janelia-experimental-technology/mouse-joystick-pcb/docs/generated/mechanical/board-dimensions.md

# mouse-joystick-pcb Board Dimensions

Generated by `export_board_geometry.py`. Do not edit by hand.

All coordinates are millimetres in a right-handed frame whose **origin is the
centre of the board outline**, with **X to the right and Y up** when looking at
the top of the board. This is the frame mechanical CAD wants; it is not KiCad's.
The frame origin sits at KiCad coordinates (137.425, 95.0).

## Drawing

Outline and mounting holes, dimensioned

The outline and the mounting holes dimensioned, plotted by KiCad from a copy of the board with the dimensions on its `Dwgs.User` layer: [SVG](board-dimensions.svg) · [PDF](board-dimensions.pdf) (the PDF is the board's page, 1:1 when printed at 100 %). The cross is the centre of the outline, the origin of the tables below.

## Outline

| Property | Value |
| --- | --- |
| Shape | rounded rectangle |
| Width (X) | 100.0 mm |
| Height (Y) | 80.0 mm |
| Corner radius | 5.0 mm |
| X extent | -50.0 mm to 50.0 mm |
| Y extent | -40.0 mm to 40.0 mm |
| Board thickness | 1.6 mm |
| Copper layers | 4 |

## Stackup

| Layer | Type | Thickness (mm) | Material |
| --- | --- | --- | --- |
| F.SilkS | Top Silk Screen |  |  |
| F.Paste | Top Solder Paste |  |  |
| F.Mask | Top Solder Mask | 0.01 |  |
| F.Cu | copper | 0.035 |  |
| dielectric 1 | core | 0.48 | FR4 |
| In1.Cu | copper | 0.035 |  |
| dielectric 2 | prepreg | 0.48 | FR4 |
| In2.Cu | copper | 0.035 |  |
| dielectric 3 | core | 0.48 | FR4 |
| B.Cu | copper | 0.035 |  |
| B.Mask | Bottom Solder Mask | 0.01 |  |
| B.Paste | Bottom Solder Paste |  |  |
| B.SilkS | Bottom Silk Screen |  |  |

## Mounting Holes

| Ref | X (mm) | Y (mm) | Drill (mm) | Plated |
| --- | ---: | ---: | ---: | --- |
| H101 | -45.0 | 35.0 | 3.2 | no |
| H102 | 45.0 | 35.0 | 3.2 | no |
| H103 | 45.0 | -35.0 | 3.2 | no |
| H104 | -45.0 | -35.0 | 3.2 | no |

Unplated holes that belong to a connector or switch rather than to the
enclosure. They are drilled in the board but need no enclosure hardware.

| Ref | X (mm) | Y (mm) | Drill (mm) |
| --- | ---: | ---: | ---: |
| J201 | -45.0 | -15.0 | 0.71 |
| J201 | -45.0 | -7.0 | 0.71 |
| J301 | -42.9 | 13.715 | 3.25 |
| J301 | -42.9 | 2.285 | 3.25 |
| SW601 | -46.125 | -27.5 | 0.75 |
| SW601 | -48.875 | -27.5 | 0.75 |
| SW602 | -46.125 | -20.5 | 0.75 |
| SW602 | -48.875 | -20.5 | 0.75 |

## Connectors and Controls

`X` and `Y` are the footprint origin. The courtyard columns are the part's
keep-clear rectangle in the same frame, which is what a panel cutout needs.

| Ref | Value | Side | X (mm) | Y (mm) | Rot | Courtyard X | Courtyard Y |
| --- | --- | --- | ---: | ---: | ---: | --- | --- |
| J201 | USB-C | top | -45.0 | -11.0 | 90 | -47.31 to -42.69 | -16.05 to -5.95 |
| J301 | RJ45-8P8C | top | -41.0 | 8.0 | 270 | -50.0 to -32.0 | -0.5 to 16.5 |
| J501 | TBH-1x02-5.08mm | top | -44.0 | 24.0 | 270 | -48.3 to -38.7 | 17.41 to 30.58 |
| J901 | Conn_Coaxial_HL-BNC-KHDA | top | 16.0 | -15.0 | 0 | 9.5 to 22.5 | -21.5 to -8.5 |
| J1101 | Conn_Coaxial_HL-BNC-KHDA | top | -8.0 | -15.0 | 180 | -14.5 to -1.5 | -21.5 to -8.5 |
| J1102 | TBH-1x04-3.5mm | top | -21.0 | 36.0 | 180 | -29.2 to -12.8 | 31.25 to 39.5 |
| J1103 | TBH-1x05-3.5mm | top | 1.0 | 36.0 | 180 | -8.95 to 10.95 | 31.25 to 39.5 |
| J1301 | FH12-50S-0.5SVA(54) | top | 0.0 | -36.0 | 180 | -14.75 to 14.75 | -38.8 to -33.2 |
| J1601 | TBH-1x02-3.5mm | top | 18.0 | 36.0 | 180 | 13.3 to 22.7 | 31.25 to 39.5 |
| J1801 | TBH-1x02-3.5mm | top | 37.0 | -12.0 | 180 | 32.3 to 41.7 | -16.75 to -8.5 |
| J2001 | TBH-1x05-3.5mm | top | 37.0 | 18.0 | 180 | 27.05 to 46.95 | 13.25 to 21.5 |
| SW601 | 436333045822 | top | -47.5 | -27.5 | 270 | -49.5 to -45.5 | -31.0 to -24.0 |
| SW602 | 436333045822 | top | -47.5 | -20.5 | 270 | -49.5 to -45.5 | -24.0 to -17.0 |
