janelia-experimental-technology/mouse-joystick-pcb/docs/index.md

# mouse-joystick-pcb

<!-- Generated by orb-weaver-kicad-docs (scripts/board_view.py); do not edit. -->

Single-axis mouse joystick: RP2040 with GPIO isolation, one TMC5130A, torque bridge, brake current sink, analog angle output, InstrumentPort-Digital-50 taps, 36 V protected input with 12 V and 5 V regulators; v1.0 as built.

The assembled board with its design blocks numbered. On the site the picture is a model that turns, or the top
render where WebGL is absent, and each number is a link to the block's page: its schematic, parts, ports and
placement guidance. Read on the forge, the picture is the plain top render and the table below is the key.

<script type="module" src="https://ajax.googleapis.com/ajax/libs/model-viewer/4.0.0/model-viewer.min.js"></script>

<script>
(function(){try{var c=document.createElement('canvas');if('customElements' in window&&(c.getContext('webgl2')||c.getContext('webgl')))document.documentElement.classList.add('webgl');}catch(e){}})();
</script>

<style>
.board-3d{display:none}html.webgl .board-3d{display:block}html.webgl .board-2d{display:none}.board-plain{display:none}
@media print{.board-3d{display:none !important}.board-2d{display:block !important}}
.hotspot{display:block;width:22px;height:22px;border-radius:11px;border:2px solid #fff;background:#d9480f;color:#fff;font:bold 11px/18px sans-serif;text-align:center;text-decoration:none;box-shadow:0 1px 3px rgba(0,0,0,.4)}
.hotspot::before{content:attr(data-n)}.hotspot:hover{background:#a63a0b}
.board-hint{font-size:.8em;opacity:.75;margin:.4em 0 0}
</style>

<div class="board-3d">
<model-viewer id="board" src="generated/3d/mouse-joystick-pcb.glb?v=259a838d8eb5" alt="The assembled mouse-joystick-pcb" camera-controls touch-action="pan-y"
 camera-orbit="0deg 30deg auto" field-of-view="30deg" shadow-intensity="0.5" exposure="0.75" interaction-prompt="none"
 style="width:100%;height:560px;background:#fff;border-radius:8px">

</model-viewer>
<p class="board-hint">Drag to turn, scroll to zoom; the numbers are links.</p>
<script>
(function(){var mv=document.getElementById('board');if(!mv)return;
var fallback=function(){document.documentElement.classList.remove('webgl');};
mv.addEventListener('error',fallback);var t=setTimeout(fallback,20000);
if(window.customElements)customElements.whenDefined('model-viewer').then(function(){clearTimeout(t);});})();
</script>
</div>

<div class="board-2d">
<object data="generated/3d/top.svg?v=ad2ede290a01" type="image/svg+xml" style="width:100%" aria-label="The top of the board with the blocks numbered"></object>
<p class="board-hint">The numbers are links; in a browser with WebGL this picture is a model that turns.</p>
</div>

<div class="board-plain" markdown>

Top, straight down

</div>

| # | Block instance | Library block | On sheet | Side | Parts |
| ---: | --- | --- | --- | --- | ---: |
| 1 | [`hv_input_36V_terminal_2pos_5p08_protected_vertical`](generated/blocks/hv_input_36V_terminal_2pos_5p08_protected_vertical.md) | `orb_weaver_private:hv_input_36V_terminal_2pos_5p08_protected_vertical` | `/` | top | 18 |
| 2 | [`quadrature_encoder_input_5v_sn74lvc2g17`](generated/blocks/quadrature_encoder_input_5v_sn74lvc2g17.md) | `orb_weaver_private:quadrature_encoder_input_5v_sn74lvc2g17` | `/motor_encoder_switch` | top | 14 |
| 3 | [`limit_switch_debounced_input_vertical`](generated/blocks/limit_switch_debounced_input_vertical.md) | `orb_weaver_private:limit_switch_debounced_input_vertical` | `/motor_encoder_switch` | top | 5 |
| 4 | [`hv_to_12v_tpsm365r6`](generated/blocks/hv_to_12v_tpsm365r6.md) | `orb_weaver_tpsm365r6_adjustable:tpsm365r6_adjustable_12v` | `/brake_torque_sensor` | top | 13 |
| 5 | [`pycontrol_behavior_port_rj45_boundary_vertical`](generated/blocks/pycontrol_behavior_port_rj45_boundary_vertical.md) | `orb_weaver_private:pycontrol_behavior_port_rj45_boundary_vertical` | `/` | top | 9 |
| 6 | [`hv_to_5v_tpsm365r6`](generated/blocks/hv_to_5v_tpsm365r6.md) | `orb_weaver_tpsm365r6_fixed:tpsm365r6_fixed_5v` | `/` | top | 9 |
| 7 | [`tmc5130`](generated/blocks/tmc5130.md) | `orb_weaver_tmc5130:tmc5130_spi_r150` | `/motor_encoder_switch` | top | 27 |
| 8 | [`torque_bridge_0_3v3_ina821`](generated/blocks/torque_bridge_0_3v3_ina821.md) | `orb_weaver_private:torque_bridge_0_3v3_ina821` | `/brake_torque_sensor` | top | 63 |
| 9 | [`rp2040_with_gpio_isolation_sn74cb3q3245`](generated/blocks/rp2040_with_gpio_isolation_sn74cb3q3245.md) | `orb_weaver_private:rp2040_with_gpio_isolation_sn74cb3q3245` | `/mcu` | top | 35 |
| 10 | [`usb2_vertical`](generated/blocks/usb2_vertical.md) | `orb_weaver_private:usb2_vertical` | `/` | top | 6 |
| 11 | [`5v_to_3v3_tps73733_1`](generated/blocks/5v_to_3v3_tps73733_1.md) | `orb_weaver_private:5v_to_3v3_tps73733` | `/mcu` | top | 3 |
| 12 | [`5v_to_3v3_tps73733_2`](generated/blocks/5v_to_3v3_tps73733_2.md) | `orb_weaver_private:5v_to_3v3_tps73733` | `/` | top | 3 |
| 13 | [`analog_output_0_3v3_dac80501`](generated/blocks/analog_output_0_3v3_dac80501.md) | `orb_weaver_private:analog_output_0_3v3_dac80501` | `/motor_encoder_switch` | top | 28 |
| 14 | [`brake_current_sink_0_49ma_dac80501`](generated/blocks/brake_current_sink_0_49ma_dac80501.md) | `orb_weaver_private:brake_current_sink_0_49ma_dac80501` | `/brake_torque_sensor` | top | 54 |
| 15 | [`instrument_port_digital_50_dut_ffc_boundary_vertical`](generated/blocks/instrument_port_digital_50_dut_ffc_boundary_vertical.md) | `orb_weaver_private:instrument_port_digital_50_dut_ffc_boundary_vertical` | `/instrument_port` | top | 46 |

The numbers run left to right, top to bottom over the top view. The model is
[`3d/mouse-joystick-pcb.glb`](generated/3d/mouse-joystick-pcb.glb) (metres, Y up, the board's x and y along X and Z); the drawing
[`3d/top.svg`](generated/3d/top.svg) is [`3d/top.png`](generated/3d/top.png) at
12.38 px/mm with one rectangle per block, the union of its footprints' courtyards; both and the
footprints of each block are recorded in [`3d/hotspots.json`](generated/3d/hotspots.json).
Each block's page shows the render clipped around its rectangle.

## Where to go

- [Generated documentation](generated/README.md): the renders, every document, the bill of materials and the enclosure reference.
- [Design blocks](generated/blocks/README.md): one page per placed block, with its schematic, parts, ports and place on the board.
- [Subsystems](generated/subsystems/README.md) from their recipes, and the [MCU pin allocation](generated/gpio-allocation.md).
- The navigation lists the board's own pages.
