janelia-experimental-technology/mouse-joystick-pcb/docs/instrument-port-tap-resistors.md

# InstrumentPort Tap Resistors

**Status: implemented 2026-09-20 and verified against the exported netlist.**
This document is the build order for splitting every InstrumentPort observation
branch off its functional net with a series resistor. It is written to be
executed in a fresh session: everything needed — values, nets, owning blocks, pin
names, part numbers and the traps — is here. See
[As Built](#as-built-2026-09-20) for what actually landed and the two places the
build deviated from this specification.

**Read first:** [`docs/interface-map.md`](interface-map.md) →
[InstrumentPort-Digital-50 Pinout](interface-map.md#instrumentport-digital-50-pinout),
[Where Each Signal Is Tapped](interface-map.md#where-each-signal-is-tapped) and
[Board-Level Input Biases](interface-map.md#board-level-input-biases); then
[`docs/design-block-map.md`](design-block-map.md) for the re-place rules.

## What This Changes

Today a monitored signal is one net with three or more terminals: the driver,
the peripheral, and a long run to an `SN74LV541A` input in the port block. After
this change it is two nets joined by a series resistor — a T-tap, with the
resistor in the **branch**, never in the functional path:

```
  driver ───┬──────────────── peripheral        net: TMC_SPI_SCK      (short, direct)
            │
            └──[ R ]───────── SN74LV541A input  net: TMC_SPI_SCK_INST (long, deferrable)
```

Three things this buys, in order of how much they matter here:
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
