janelia-experimental-technology/mouse-joystick-pcb/docs/datasheets/torque-sensor-specs.png

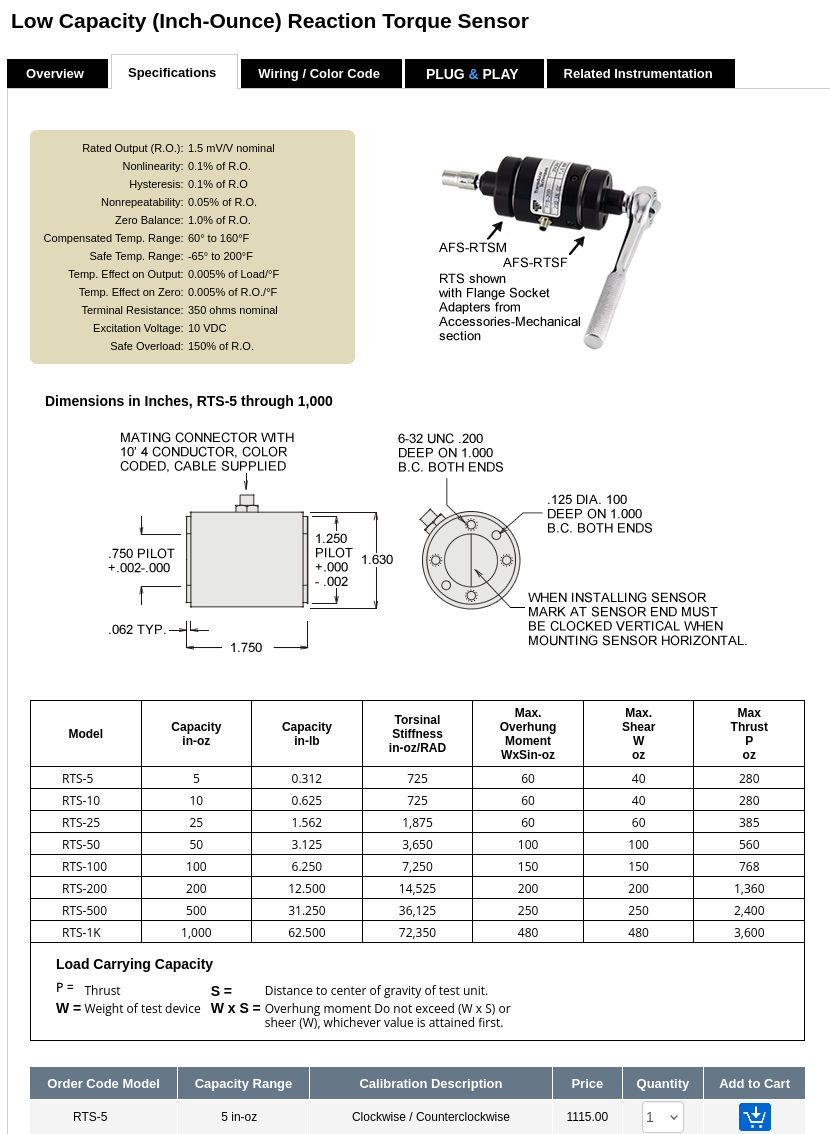
docs/datasheets/torque-sensor-specs.png
