janelia-experimental-technology/mouse-joystick-pcb/docs/diagrams/protocol-states.png

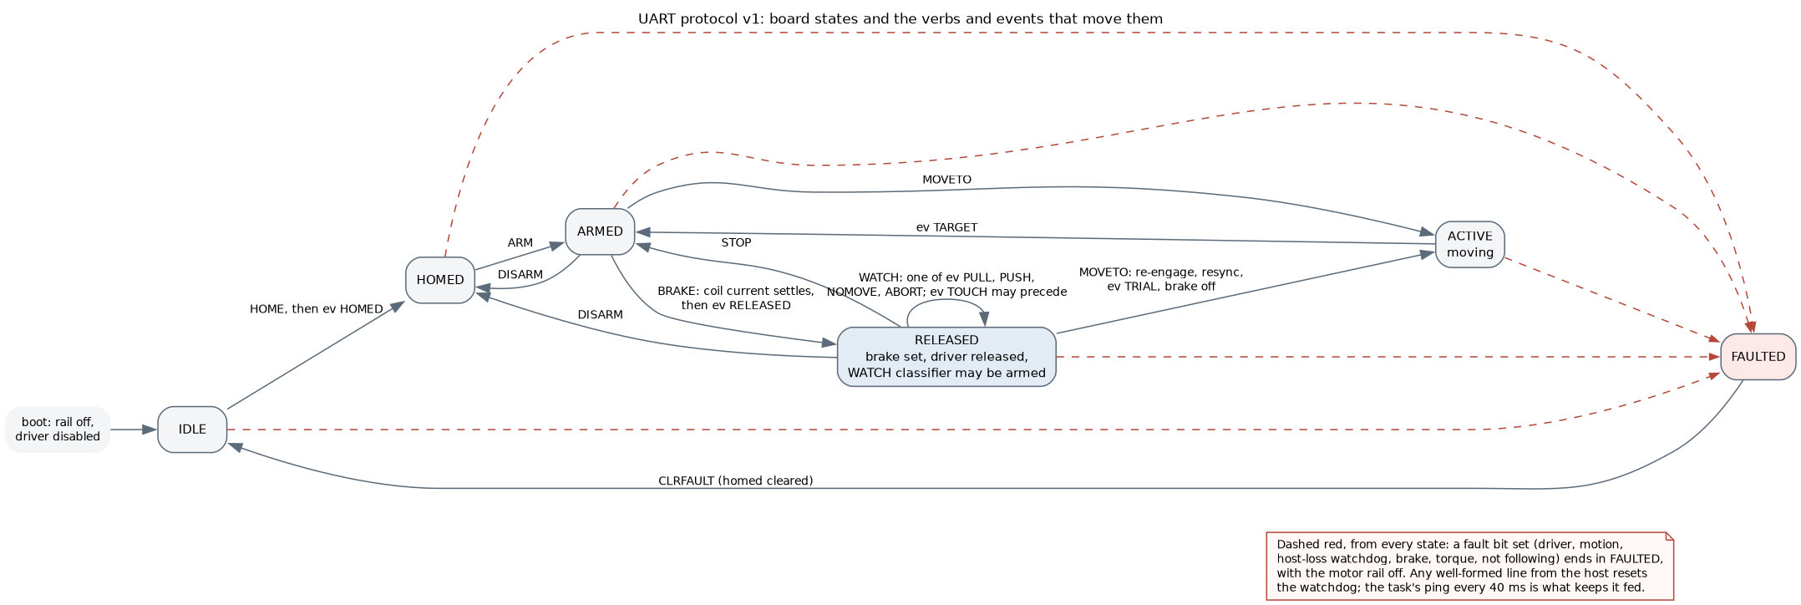
docs/diagrams/protocol-states.png
