janelia-experimental-technology/mouse-joystick-pcb/docs/generated/blocks/layout/5v_to_3v3_tps73733_1.png

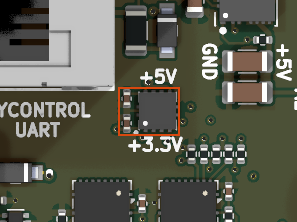
docs/generated/blocks/layout/5v_to_3v3_tps73733_1.png
