janelia-experimental-technology/mouse-joystick-pcb/docs/generated/blocks/layout/analog_output_0_3v3_dac80501.png

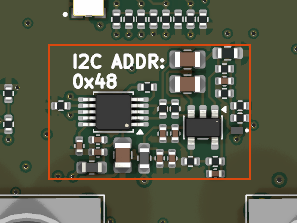
docs/generated/blocks/layout/analog_output_0_3v3_dac80501.png
