janelia-experimental-technology/mouse-joystick-pcb/docs/generated/blocks/layout/brake_current_sink_0_49ma_dac80501.png

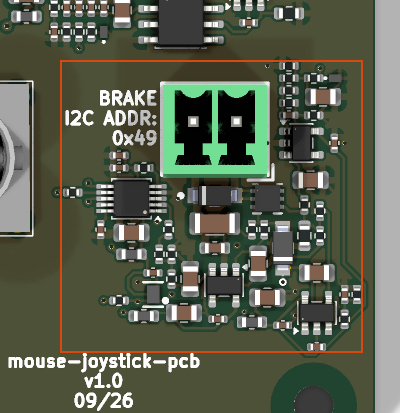
docs/generated/blocks/layout/brake_current_sink_0_49ma_dac80501.png
