janelia-experimental-technology/mouse-joystick-pcb/docs/generated/blocks/layout/hv_input_36V_terminal_2pos_5p08_protected_vertical.png

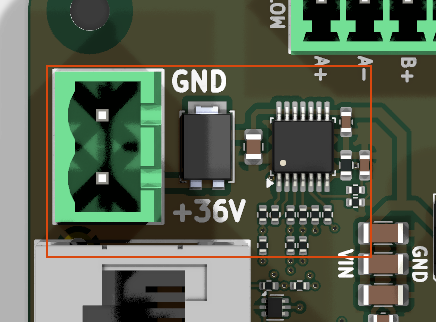
docs/generated/blocks/layout/hv_input_36V_terminal_2pos_5p08_protected_vertical.png
