janelia-experimental-technology/mouse-joystick-pcb/docs/generated/blocks/layout/hv_to_5v_tpsm365r6.png

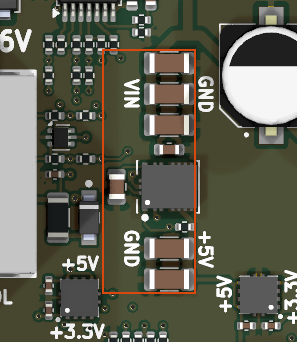
docs/generated/blocks/layout/hv_to_5v_tpsm365r6.png
