janelia-experimental-technology/mouse-joystick-pcb/docs/generated/blocks/layout/instrument_port_digital_50_dut_ffc_boundary_vertical.png

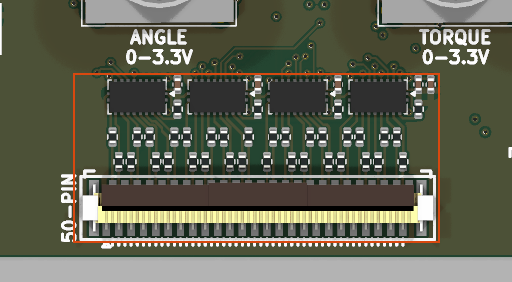
docs/generated/blocks/layout/instrument_port_digital_50_dut_ffc_boundary_vertical.png
