janelia-experimental-technology/mouse-joystick-pcb/docs/generated/blocks/layout/limit_switch_debounced_input_vertical.png

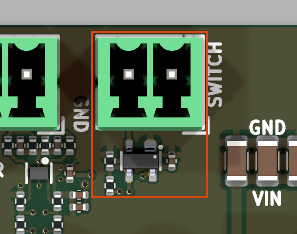
docs/generated/blocks/layout/limit_switch_debounced_input_vertical.png
