janelia-experimental-technology/mouse-joystick-pcb/docs/generated/blocks/layout/pycontrol_behavior_port_rj45_boundary_vertical.png

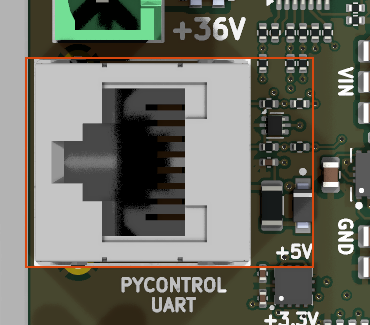
docs/generated/blocks/layout/pycontrol_behavior_port_rj45_boundary_vertical.png
