janelia-experimental-technology/mouse-joystick-pcb/docs/generated/blocks/layout/quadrature_encoder_input_5v_sn74lvc2g17.png

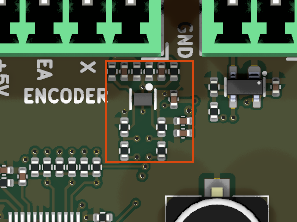
docs/generated/blocks/layout/quadrature_encoder_input_5v_sn74lvc2g17.png
