janelia-experimental-technology/mouse-joystick-pcb/docs/generated/blocks/layout/rp2040_with_gpio_isolation_sn74cb3q3245.png

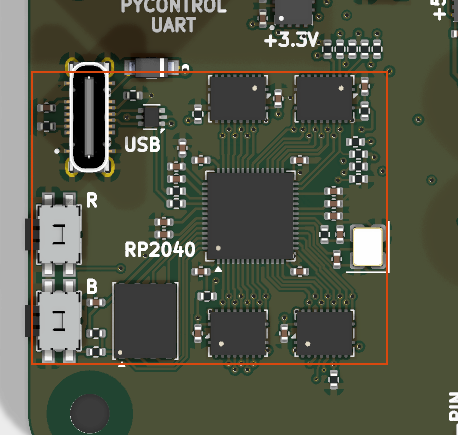
docs/generated/blocks/layout/rp2040_with_gpio_isolation_sn74cb3q3245.png
