janelia-experimental-technology/mouse-joystick-pcb/docs/generated/blocks/layout/tmc5130.png

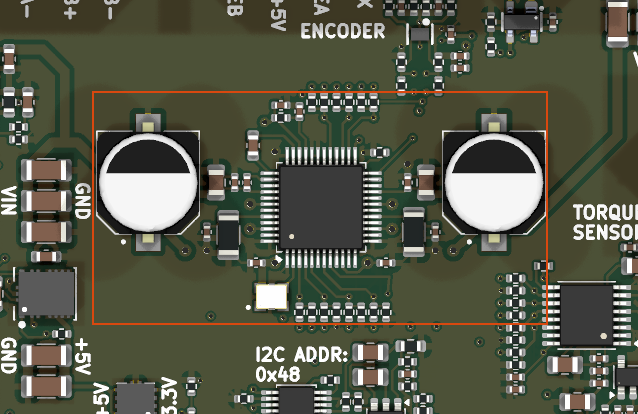
docs/generated/blocks/layout/tmc5130.png
