janelia-experimental-technology/mouse-joystick-pcb/docs/generated/blocks/layout/torque_bridge_0_3v3_ina821.png

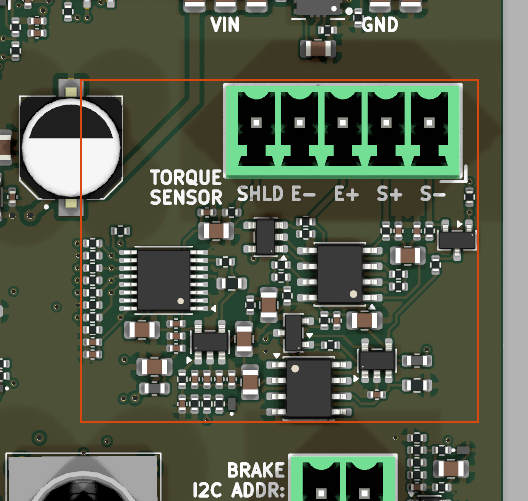
docs/generated/blocks/layout/torque_bridge_0_3v3_ina821.png
