janelia-experimental-technology/mouse-joystick-pcb/docs/generated/blocks/layout/usb2_vertical.png

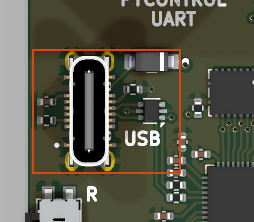
docs/generated/blocks/layout/usb2_vertical.png
