janelia-experimental-technology/mouse-joystick-pcb/docs/generated/mechanical/connectors.csv

reference | value | footprint | side | x_mm | y_mm | rotation_deg | courtyard_min_x_mm | courtyard_min_y_mm | courtyard_max_x_mm | courtyard_max_y_mm
J201 | USB-C | orb_weaver_connectors:USB_C_Receptacle_GCT_USB4145-03-0070-C_16P_Vertical | top | -45.0 | -11.0 | 90.0 | -47.31 | -16.05 | -42.69 | -5.95
J301 | RJ45-8P8C | orb_weaver_connectors:RJ45_Molex_855085001_Vertical_THT | top | -41.0 | 8.0 | 270.0 | -50.0 | -0.5 | -32.0 | 16.5
J501 | TBH-1x02-5.08mm | orb_weaver_tht:PhoenixContact_MSTBVA_2,5_2-G-5,08_1x02_P5.08mm_Vertical | top | -44.0 | 24.0 | 270.0 | -48.3 | 17.41 | -38.7 | 30.58
J901 | Conn_Coaxial_HL-BNC-KHDA | orb_weaver_connectors:CONN_BNC_HL-BNC-KHDA | top | 16.0 | -15.0 | 0.0 | 9.5 | -21.5 | 22.5 | -8.5
J1101 | Conn_Coaxial_HL-BNC-KHDA | orb_weaver_connectors:CONN_BNC_HL-BNC-KHDA | top | -8.0 | -15.0 | 180.0 | -14.5 | -21.5 | -1.5 | -8.5
J1102 | TBH-1x04-3.5mm | orb_weaver_tht:PhoenixContact_MCV_1,5_4-G-3.5_1x04_P3.50mm_Vertical | top | -21.0 | 36.0 | 180.0 | -29.2 | 31.25 | -12.8 | 39.5
J1103 | TBH-1x05-3.5mm | orb_weaver_tht:PhoenixContact_MCV_1,5_5-G-3.5_1x05_P3.50mm_Vertical | top | 1.0 | 36.0 | 180.0 | -8.95 | 31.25 | 10.95 | 39.5
J1301 | FH12-50S-0.5SVA(54) | orb_weaver_connectors:Hirose_FH12-50S-0.5SVA_1x50-4MP_P0.5mm_Vertical | top | 0.0 | -36.0 | 180.0 | -14.75 | -38.8 | 14.75 | -33.2
J1601 | TBH-1x02-3.5mm | orb_weaver_tht:PhoenixContact_MCV_1,5_2-G-3.5_1x02_P3.50mm_Vertical | top | 18.0 | 36.0 | 180.0 | 13.3 | 31.25 | 22.7 | 39.5
J1801 | TBH-1x02-3.5mm | orb_weaver_tht:PhoenixContact_MCV_1,5_2-G-3.5_1x02_P3.50mm_Vertical | top | 37.0 | -12.0 | 180.0 | 32.3 | -16.75 | 41.7 | -8.5
J2001 | TBH-1x05-3.5mm | orb_weaver_tht:PhoenixContact_MCV_1,5_5-G-3.5_1x05_P3.50mm_Vertical | top | 37.0 | 18.0 | 180.0 | 27.05 | 13.25 | 46.95 | 21.5
SW601 | 436333045822 | orb_weaver_smd:SMT_1045822_WRE | top | -47.5 | -27.5 | 270.0 | -49.5 | -31.0 | -45.5 | -24.0
SW602 | 436333045822 | orb_weaver_smd:SMT_1045822_WRE | top | -47.5 | -20.5 | 270.0 | -49.5 | -24.0 | -45.5 | -17.0
