janelia-experimental-technology/mouse-joystick-pcb/docs/generated/bom/mouse-joystick-pcb-bom.md

# mouse-joystick-pcb Bill of Materials

Generated by `orb-weaver-kicad-docs`. Do not edit by hand.

81 distinct parts, 360 placements. `LCSC` is the JLCPCB
catalog number the assembly BOM resolves to, linked to its LCSC page; the
datasheet is the catalog's where it records one (33 of 81 parts).

| Qty | References | Value | Package | Manufacturer | MPN | LCSC | Datasheet |
| --- | --- | --- | --- | --- | --- | --- | --- |
| 12 | C1001, C1002, C2017, C2019, C2021, C603, C604, C701, C702, C801, C804, C806 | 1uF | 0402 | Samsung Electro-Mechanics | CL05A105KL5NRNC | [C307413](https://www.lcsc.com/product-detail/C307413.html) |  |
| 51 | C1201, C1203, C1204, C1206, C1207, C1209, C1210, C1302, C1303, C1304, C1305, C1504, C1505, C1601, C1805, C1806, C1807, C1809, C1810, C1813, C1814, C1816, C2001, C2007, C2009, C201, C2010, C2015, C2016, C2018, C2020, C2023, C301, C605, C606, C607, C608, C609, C610, C611, C612, C613, C614, C615, C616, C617, C618, C619, C803, C805, C808 | 100nF | 0402 | Murata Electronics | GRM155R62A104KE14D | [C162178](https://www.lcsc.com/product-detail/C162178.html) |  |
| 2 | C1202, C503 | 22nF | 0603 | Murata Electronics | GCM188R72A223KA37D | [C161234](https://www.lcsc.com/product-detail/C161234.html) |  |
| 3 | C1205, C1811, C811 | 0.47uF | 0402 | Murata Electronics | GRT155R6YA474KE01D | [C711580](https://www.lcsc.com/product-detail/C711580.html) |  |
| 3 | C1208, C1301, C1501 | 4.7uF | 0402 | Murata Electronics | GRM155R61E475ME15D | [C2858031](https://www.lcsc.com/product-detail/C2858031.html) |  |
| 2 | C1211, C1212 | 2.2uF | 0805 | Murata Electronics | GRM21BD72A225KE01L | [C2981733](https://www.lcsc.com/product-detail/C2981733.html) |  |
| 2 | C1213, C1214 | 100uF | SMD,D8xL10.2mm | Panasonic Electronic Components | EEEHAH101UAP | [C336425](https://www.lcsc.com/product-detail/C336425.html) |  |
| 6 | C1502, C1503, C2003, C2005, C2022, C812 | 470pF | 0402 | Murata Electronics | GRM1555C2A471JE01D | [C1518202](https://www.lcsc.com/product-detail/C1518202.html) |  |
| 6 | C1701, C1702, C1703, C1901, C1902, C1903 | 1uF | 1206 | FH (Guangdong Fenghua Advanced Tech) | 1206B105K101NT | [C91151](https://www.lcsc.com/product-detail/C91151.html) |  |
| 3 | C1704, C1818, C1904 | 100nF | 0603 | Murata Electronics | GRM188R72A104KA35D | [C77058](https://www.lcsc.com/product-detail/C77058.html) |  |
| 2 | C1705, C1905 | 1uF | 0805 | FH (Guangdong Fenghua Advanced Tech) | 0805B105K250NT | [C89190](https://www.lcsc.com/product-detail/C89190.html) |  |
| 2 | C1706, C1707 | 22uF | 1206 | FH (Guangdong Fenghua Advanced Tech) | 1206X226M100NT | [C108717](https://www.lcsc.com/product-detail/C108717.html) |  |
| 11 | C1801, C1808, C1812, C1815, C1820, C2002, C2004, C2006, C2008, C807, C809 | 10nF | 0805 | Murata Electronics | GRM2195C1H103JA01D | [C97905](https://www.lcsc.com/product-detail/C97905.html) |  |
| 8 | C1802, C1803, C1804, C2011, C2012, C2013, C2014, C802 | 10uF | 0805 | Samsung Electro-Mechanics | CL21A106KOQNNNE | [C1713](https://www.lcsc.com/product-detail/C1713.html) |  |
| 1 | C1817 | 470nF | 1206 |  | CGA1206X7R474K101NT | [C6119998](https://www.lcsc.com/product-detail/C6119998.html) |  |
| 2 | C1819, C810 | 10pF | 0402 | Murata Electronics | GRM1555C1E100JA01D | [C161512](https://www.lcsc.com/product-detail/C161512.html) |  |
| 2 | C1906, C1907 | 10uF | 1206 | Samsung Electro-Mechanics | CL31A106KAHNNNE | [C9807](https://www.lcsc.com/product-detail/C9807.html) |  |
| 1 | C501 | 10nF | 0603 | YAGEO | CC0603JRX7R9BB103 | [C115056](https://www.lcsc.com/product-detail/C115056.html) |  |
| 1 | C502 | 220nF | 0805 | YAGEO | CC0805KKX7R0BB224 | [C513710](https://www.lcsc.com/product-detail/C513710.html) |  |
| 2 | C601, C602 | 15pF | 0402 | KEMET | C0402C150J3GACAUTO | [C3888936](https://www.lcsc.com/product-detail/C3888936.html) |  |
| 3 | D1801, D201, D301 | MBR120VLSFT1G | SOD-123FL | onsemi | MBR120VLSFT1G | [C223608](https://www.lcsc.com/product-detail/C223608.html) | [datasheet](https://www.onsemi.com/pdf/datasheet/mbr120vlsft1-d.pdf) |
| 1 | D1802 | S115Q | SOD-123FL | Yangzhou Yangjie Electronic Technology | S115Q | [C5362393](https://www.lcsc.com/product-detail/C5362393.html) | [datasheet](https://www.lcsc.com/product-detail/C5362393.html) |
| 3 | D1803, D2001, D801 | TPD1E05U06DPYR | X1SON-2(0.6x1) | Texas Instruments | TPD1E05U06DPYR | [C436349](https://www.lcsc.com/product-detail/C436349.html) | [datasheet](https://www.ti.com/lit/ds/symlink/tpd1e05u06.pdf) |
| 1 | D501 | SBRT15U50SP5-13 | PowerDI-5 | Diodes Incorporated | SBRT15U50SP5-13 | [C211388](https://www.lcsc.com/product-detail/C211388.html) | [datasheet](https://www.diodes.com/assets/Datasheets/SBRT15U50SP5.pdf) |
| 7 | FB1801, FB1802, FB1803, FB2001, FB2002, FB801, FB802 | 600R@100MHz | 0603 | Taiyo Yuden | FCM1608KF-601T03 | [C141723](https://www.lcsc.com/product-detail/C141723.html) |  |
| 2 | J1101, J901 | Conn_Coaxial_HL-BNC-KHDA | Plugin | Shenzhen HenryTech | HL-BNC-KHDA | [C19712152](https://www.lcsc.com/product-detail/C19712152.html) | [datasheet](https://jlcpcb.com/partdetail/C19712152) |
| 1 | J1102 | TBH-1x04-3.5mm | Plugin,P=3.5mm | Phoenix Contact | 1843622 | [C480549](https://www.lcsc.com/product-detail/C480549.html) | [datasheet](https://www.phoenixcontact.com/en-pc/products/1843622) |
| 2 | J1103, J2001 | TBH-1x05-3.5mm | Plugin,P=3.5mm | Phoenix Contact | 1843635 | [C5451793](https://www.lcsc.com/product-detail/C5451793.html) | [datasheet](https://www.phoenixcontact.com/en-pc/products/1843635) |
| 1 | J1301 | FH12-50S-0.5SVA(54) | SMD,P=0.5mm | Hirose Electric | FH12-50S-0.5SVA(54) | [C597991](https://www.lcsc.com/product-detail/C597991.html) | [datasheet](https://www.hirose.com/product/en/products/FH12/FH12-50S-0.5SVA%2854%29/) |
| 2 | J1601, J1801 | TBH-1x02-3.5mm | Plugin,P=3.5mm | Phoenix Contact | 1843606 | [C3019639](https://www.lcsc.com/product-detail/C3019639.html) | [datasheet](https://www.phoenixcontact.com/en-pc/products/1843606) |
| 1 | J201 | USB-C | SMD | Global Connector Technology | USB4145-03-0070-C | [C5815189](https://www.lcsc.com/product-detail/C5815189.html) | [datasheet](https://gct.co/files/drawings/usb4145.pdf) |
| 1 | J301 | RJ45-8P8C | Plugin | Molex | 855085001 | [C588558](https://www.lcsc.com/product-detail/C588558.html) | [datasheet](https://www.molex.com/en-us/products/part-detail-pdf/855085001?display=pdf) |
| 1 | J501 | TBH-1x02-5.08mm | Plugin,P=5.08mm | Phoenix Contact | 1755736 | [C480503](https://www.lcsc.com/product-detail/C480503.html) | [datasheet](https://www.phoenixcontact.com/en-pc/products/1755736) |
| 1 | Q2001 | 2SK1589-T1B-VB | SOT-23 | VBsemi Elec | 2SK1589-T1B-VB | [C724949](https://www.lcsc.com/product-detail/C724949.html) | [datasheet](https://www.lcsc.com/product-detail/C724949.html) |
| 1 | Q2002 | MMBT5550LT1G | SOT-23 | onsemi | MMBT5550LT1G | [C150072](https://www.lcsc.com/product-detail/C150072.html) | [datasheet](https://www.onsemi.com/pdf/datasheet/mmbt5550lt1-d.pdf) |
| 29 | R1101, R1102, R1103, R1104, R1105, R1106, R1107, R1201, R1301, R1302, R1303, R1304, R1701, R2011, R2012, R401, R404, R405, R502, R503, R504, R506, R507, R605, R901, R902, R903, R904, R905 | 10k | 0402 | PANASONIC | ERJ2GEJ103X | [C278577](https://www.lcsc.com/product-detail/C278577.html) |  |
| 3 | R1202, R2002, R2014 | 10 | 0402 | YAGEO | RC0402FR-0710RL | [C138066](https://www.lcsc.com/product-detail/C138066.html) |  |
| 2 | R1203, R1204 | 0.15 | 1206 | TA-I Tech | RLH12FTCR150 | [C2683383](https://www.lcsc.com/product-detail/C2683383.html) |  |
| 48 | R1205, R1206, R1207, R1208, R1305, R1306, R1307, R1308, R1309, R1310, R1311, R1312, R1313, R1314, R1315, R1316, R1317, R1318, R1319, R1320, R1321, R1322, R1323, R1324, R1325, R1326, R1327, R1328, R1329, R1330, R1331, R1332, R1333, R1334, R1335, R1336, R1507, R1508, R2024, R2025, R2026, R2027, R301, R302, R304, R305, R410, R411 | 100 | 0402 | UNI-ROYAL(Uniroyal Elec) | 0402WGF1000TCE | [C25076](https://www.lcsc.com/product-detail/C25076.html) |  |
| 26 | R1209, R1210, R1211, R1602, R1807, R1809, R1813, R1820, R2004, R2005, R2013, R2022, R2028, R408, R409, R501, R505, R510, R511, R512, R603, R604, R606, R806, R808, R810 | 1k | 0402 | YAGEO | RC0402FR-071KL | [C106235](https://www.lcsc.com/product-detail/C106235.html) |  |
| 5 | R1501, R1502, R1505, R1506, R1601 | 100k | 0402 | YAGEO | RC0402JR-07100KL | [C106234](https://www.lcsc.com/product-detail/C106234.html) |  |
| 7 | R1503, R1504, R1903, R402, R403, R406, R407 | 4.7k | 0402 | UNI-ROYAL(Uniroyal Elec) | 0402WGF4701TCE | [C25900](https://www.lcsc.com/product-detail/C25900.html) |  |
| 10 | R1801, R1817, R1902, R1905, R2006, R2007, R2008, R2017, R2018, R803 | 10k | 0402 | Panasonic Electronic Components | ERA2AEB103X | [C191915](https://www.lcsc.com/product-detail/C191915.html) |  |
| 6 | R1802, R1805, R1806, R1811, R1814, R1815 | 49.9k | 0402 | YAGEO | RC0402FR-0749K9L | [C137969](https://www.lcsc.com/product-detail/C137969.html) |  |
| 10 | R1803, R1804, R1808, R1810, R1821, R2016, R2020, R804, R807, R811 | 3.2k | 0402 | Yageo | RT0402BRD073K2L | [C705066](https://www.lcsc.com/product-detail/C705066.html) |  |
| 1 | R1812 | 6.34k | 0402 | LIZ Elec | CR0402FF6341G | [C100502](https://www.lcsc.com/product-detail/C100502.html) |  |
| 1 | R1816 | 10 | 0603 | ROHM Semicon | KTR03EZPF10R0 | [C2090788](https://www.lcsc.com/product-detail/C2090788.html) |  |
| 2 | R1818, R1904 | 110k | 0402 | FOJAN | FRC0402F1103TS | [C2909311](https://www.lcsc.com/product-detail/C2909311.html) |  |
| 5 | R1819, R2021, R2023, R509, R809 | 249 | 0402 | Vishay Intertech | CRCW0402249RFKED | [C482112](https://www.lcsc.com/product-detail/C482112.html) |  |
| 2 | R1901, R607 | 7.87k | 0402 | FOJAN | FRC0402F7871TS | [C2998145](https://www.lcsc.com/product-detail/C2998145.html) |  |
| 1 | R2001 | 249 | 0402 | Yageo | RT0402BRD07249RL | [C852662](https://www.lcsc.com/product-detail/C852662.html) |  |
| 1 | R2003 | 75k | 0402 | Yageo | RT0402BRD0775KL | [C728563](https://www.lcsc.com/product-detail/C728563.html) |  |
| 1 | R2009 | 0 | 0402 | UNI-ROYAL(Uniroyal Elec) | 0402WGF0000TCE | [C17168](https://www.lcsc.com/product-detail/C17168.html) |  |
| 2 | R201, R202 | 5.1k | 0402 | Panasonic Electronic Components | ERJ2GEJ512X | [C413002](https://www.lcsc.com/product-detail/C413002.html) |  |
| 2 | R2010, R802 | 13k | 0402 | FOJAN | FRC0402F1302TS | [C2909319](https://www.lcsc.com/product-detail/C2909319.html) |  |
| 3 | R2015, R2019, R805 | 100k | 0603 | UNI-ROYAL(Uniroyal Elec) | 0603WAF1003T5E | [C25803](https://www.lcsc.com/product-detail/C25803.html) |  |
| 1 | R303 | 0.36 | 1206 | YAGEO | RL1206FR-070R36L | [C327079](https://www.lcsc.com/product-detail/C327079.html) |  |
| 1 | R508 | 40k | 0603 | VO | SCR0603F40K | [C3016445](https://www.lcsc.com/product-detail/C3016445.html) |  |
| 2 | R601, R602 | 27 | 0402 | Panasonic Electronic Components | ERJ2GEJ270X | [C278580](https://www.lcsc.com/product-detail/C278580.html) |  |
| 1 | R801 | 20k | 0402 | UNI-ROYAL(Uniroyal Elec) | 0402WGF2002TCE | [C25765](https://www.lcsc.com/product-detail/C25765.html) |  |
| 2 | SW601, SW602 | 436333045822 | - | Würth Elektronik | 436333045822 | [C7185056](https://www.lcsc.com/product-detail/C7185056.html) | [datasheet](https://www.we-online.com/components/products/datasheet/436333045822.pdf) |
| 2 | U1001, U701 | TPS73733QDRBRQ1 | VSON-8-EP(3x3) | Texas Instruments | TPS73733QDRBRQ1 | [C523768](https://www.lcsc.com/product-detail/C523768.html) | [datasheet](https://www.ti.com/lit/ds/symlink/tps737-q1.pdf) |
| 1 | U1201 | TMC5130A-TA-T | TQFP-48-EP(7x7) | Analog Devices Inc./Maxim Integrated | TMC5130A-TA-T | [C188832](https://www.lcsc.com/product-detail/C188832.html) | [datasheet](https://www.analog.com/media/en/technical-documentation/data-sheets/TMC5130A_datasheet_rev1.21.pdf) |
| 4 | U1301, U1302, U1303, U1304 | SN74LV541ARKSR | VQFN-20(2.5x4.5) | Texas Instruments | SN74LV541ARKSR | [C7364695](https://www.lcsc.com/product-detail/C7364695.html) | [datasheet](https://www.ti.com/lit/ds/symlink/sn74lv541a.pdf) |
| 2 | U1501, U1803 | SN74LVC2G17DRYR | SON-6(1x1.5) | Texas Instruments | SN74LVC2G17DRYR | [C2675856](https://www.lcsc.com/product-detail/C2675856.html) | [datasheet](https://www.ti.com/lit/ds/symlink/sn74lvc2g17.pdf) |
| 1 | U1601 | MAX6816EUS+T | SOT-143 | Analog Devices Inc./Maxim Integrated | MAX6816EUS+T | [C41637](https://www.lcsc.com/product-detail/C41637.html) | [datasheet](https://www.analog.com/media/en/technical-documentation/data-sheets/MAX6816-MAX6818.pdf) |
| 1 | U1701 | TPSM365R6V5RDNR | QFN-11(3.5x4.5) | Texas Instruments | TPSM365R6V5RDNR | [C19078014](https://www.lcsc.com/product-detail/C19078014.html) | [datasheet](https://www.ti.com/lit/ds/symlink/tpsm365r6.pdf) |
| 2 | U1801, U801 | DAC80501ZDGSR | VSSOP-10-0.5mm | Texas Instruments | DAC80501ZDGSR | [C1852033](https://www.lcsc.com/product-detail/C1852033.html) | [datasheet](https://www.ti.com/lit/ds/symlink/dac80501.pdf) |
| 7 | U1802, U1804, U1806, U2003, U2005, U2006, U802 | OPA197IDBVR | SOT-23-5 | Texas Instruments | OPA197IDBVR | [C221351](https://www.lcsc.com/product-detail/C221351.html) | [datasheet](https://www.ti.com/lit/ds/symlink/opa197.pdf) |
| 1 | U1805 | BUK7D36-60EX | DFN2020MD-6 | Nexperia USA Inc. | BUK7D36-60EX | [C3288253](https://www.lcsc.com/product-detail/C3288253.html) | [datasheet](https://assets.nexperia.com/documents/data-sheet/BUK7D36-60E.pdf) |
| 1 | U1901 | TPSM365R6FRDNR | QFN-11(3.5x4.5) | Texas Instruments | TPSM365R6FRDNR | [C6723000](https://www.lcsc.com/product-detail/C6723000.html) | [datasheet](https://www.ti.com/lit/ds/symlink/tpsm365r6.pdf) |
| 1 | U2001 | INA821IDR | SOIC-8 | Texas Instruments | INA821IDR | [C2060822](https://www.lcsc.com/product-detail/C2060822.html) | [datasheet](https://www.ti.com/lit/ds/symlink/ina821.pdf) |
| 1 | U2002 | ADS8689IPWR | TSSOP-16 | Texas Instruments | ADS8689IPWR | [C135986](https://www.lcsc.com/product-detail/C135986.html) | [datasheet](https://www.ti.com/lit/ds/symlink/ads8689.pdf) |
| 1 | U2004 | REF5010AIDR | SOIC-8 | Texas Instruments | REF5010AIDR | [C913836](https://www.lcsc.com/product-detail/C913836.html) | [datasheet](https://www.ti.com/lit/ds/symlink/ref5010.pdf) |
| 2 | U201, U301 | USBLC6-2P6 | SOT-666-6 | STMicroelectronics | USBLC6-2P6 | [C2827693](https://www.lcsc.com/product-detail/C2827693.html) | [datasheet](https://www.st.com/resource/en/datasheet/usblc6-2.pdf) |
| 1 | U501 | TPS1HTC100QPWPRQ1 | HTSSOP-14 | Texas Instruments | TPS1HTC100QPWPRQ1 | [C41558366](https://www.lcsc.com/product-detail/C41558366.html) | [datasheet](https://www.ti.com/lit/ds/symlink/tps1htc100-q1.pdf) |
| 1 | U601 | RP2040 | LQFN-56(7x7) | Raspberry Pi | RP2040 | [C2040](https://www.lcsc.com/product-detail/C2040.html) | [datasheet](https://datasheets.raspberrypi.com/rp2040/rp2040-datasheet.pdf) |
| 1 | U602 | W25Q128JVPIQ | WSON-8-EP(5x6) | Winbond Electronics | W25Q128JVPIQ | [C190862](https://www.lcsc.com/product-detail/C190862.html) | [datasheet](https://www.winbond.com/resource-files/W25Q128JV%20RevI%2008232021%20Plus.pdf) |
| 4 | U603, U604, U605, U606 | SN74CB3Q3245RGYR | VQFN-20-EP(3.5x4.5) | Texas Instruments | SN74CB3Q3245RGYR | [C201559](https://www.lcsc.com/product-detail/C201559.html) | [datasheet](https://www.ti.com/lit/ds/symlink/sn74cb3q3245.pdf) |
| 1 | X1201 | 16MHz | SMD2520-4P | ECS Inc. | ECS-2520S33-160-FN-TR | [C2451298](https://www.lcsc.com/product-detail/C2451298.html) |  |
| 1 | Y601 | 12MHz | SMD3225-4P | Abracon LLC | ABM8-272-T3 | [C20625731](https://www.lcsc.com/product-detail/C20625731.html) |  |
