janelia-experimental-technology/mouse-joystick-pcb/docs/generated/3d/mouse-joystick-pcb-assembled.step

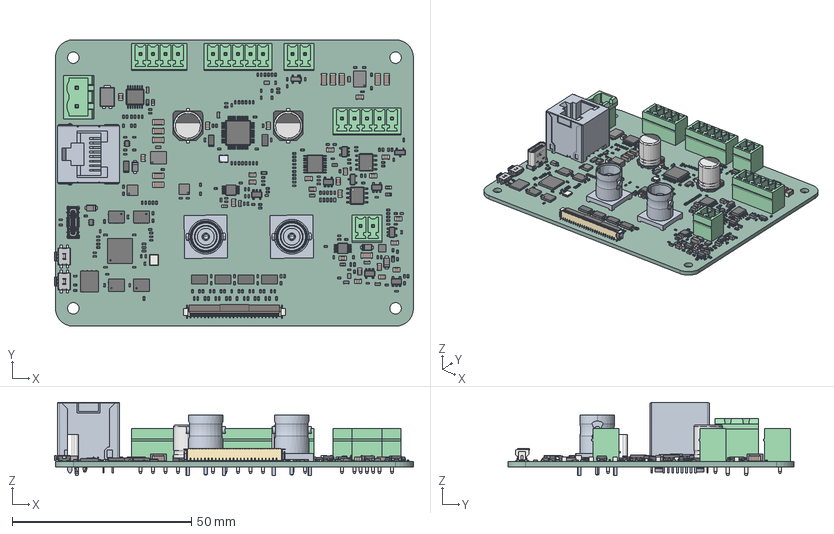
[picture p28: CAD file, 2026-10-15]
docs/generated/3d/mouse-joystick-pcb-assembled.step
100.3 x 80.0 x 20.5 mm
R_0402_1005Metric x 164
C_0402_1005Metric x 79
C_0805_2012Metric x 24
C_0603_1608Metric x 6
ECS-2520S18-050-EN-TR
R_0603_1608Metric x 5
SOT-23-5 x 7
C_1206_3216Metric x 11
MCV_01x05_G_3_5mm x 2
DRB8B x 2
frame x 2
pins x 2
pins001 x 2
pins002 x 2
pins003 x 2
stem x 2
cover x 2
NTS260SFT1G x 4
TQFP-48-1EP_7x7mm_P0.5mm_EP5x5mm
43e594cd-ed20-11ed-b06b-f76ff2fea4fd_part x 4
43e594ce-ed20-11ed-b06b-f76ff2fea4fd_part x 4
43e594cf-ed20-11ed-b06b-f76ff2fea4fd_part x 4
MSTBVA_01x02_G_5_08mm
BODY-QFN x 4
112406_SW0001 x 2
R_1206_3216Metric x 3
DPY2 x 3
TSSOP-16_4.4x5mm_P0.65mm
SOT-23 x 2
MCV_01x02_G_3_5mm x 2
L_0603_1608Metric x 7
RDN11 x 2
MCV_01x04_G_3_5mm
WSON-8-1EP_6x5mm_P1.27mm_EP3.4x4.3mm
PDS1040L-13
Housing
Actuator
Leads
Fittings
Crystal_SMD_3225-4Pin_3.2x2.5mm
SOIC-8_3.9x4.9mm_P1.27mm x 2
MSOP-10_3x3mm_P0.5mm x 2
SOT_666 x 2
BODY-SON x 2
FRAME-DRY0006B x 2
PIN1-ID x 2
Texas_HTSSOP-14-1EP_4.4x5mm_P0.65mm_EP3.4x5mm_Mask3.155x3.255mm
QFN-56-1EP_7x7mm_P0.4mm_EP3.2x3.2mm
MAX6816EUS+T
EEE-1EA101P x 2
mouse-joystick-pcb_PCB
