janelia-experimental-technology/mouse-joystick-pcb/docs/datasheets/motor-wiring.png

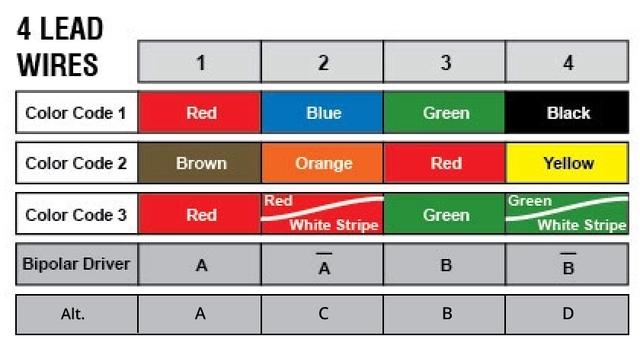
docs/datasheets/motor-wiring.png
