janelia-experimental-technology/mouse-joystick-pcb/docs/generated/mechanical/board-dimensions.pdf

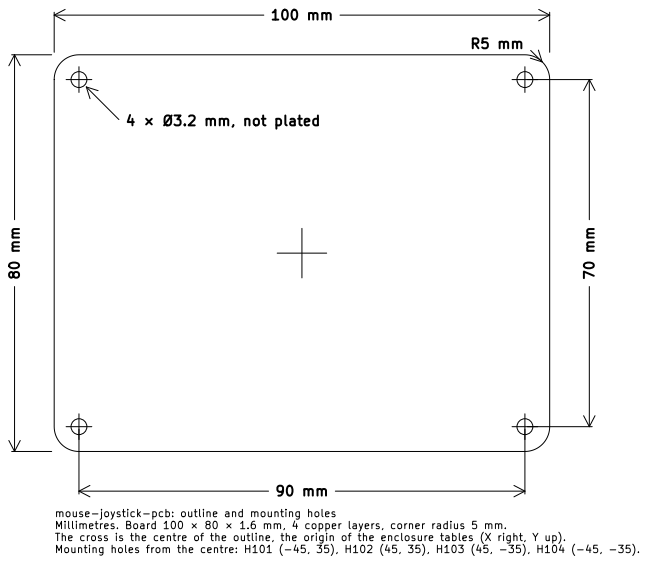
[picture p30: page 1]

mouse-joystick-pcb: outline and mounting holes
Millimetres. Board 100 × 80 × 1.6 mm, 4 copper layers, corner radius 5 mm. The cross is the centre of the outline, the origin of the enclosure tables (X right, Y up).

Mounting holes from the centre: H101 (-45, 35), H102 (45, 35), H103 (45, -35), H104 (-45, -35).
