janelia-experimental-technology/mouse-joystick-pcb/(list of files, drawings)

Other design files:
fab/mouse-joystick-pcb/reports/schematic-parity.json
