janelia-experimental-technology/mouse-joystick-pcb/(commit log)

2026-08-13 Update date
    [mouse-joystick-pcb.kicad_pcb, mouse-joystick-pcb.kicad_sch]
2026-08-13 Add items to schematic
    [hv_input_36V_terminal_2pos_5p08_protected.kicad_sch, mcu.kicad_sch, mouse-joystick-pcb.kicad_sch, usb2.kicad_sch]
2026-08-14 Add design blocks
    [5v_to_3v3_tps73733.kicad_sch, mcu.kicad_sch, rp2040.kicad_sch, rp2040_gpio_isolation_sn74cb3q3245.kicad_sch]
2026-08-14 Revise plans based on power switch
2026-08-14 Update documentation
    [5v_to_3v3_tps73733.kicad_sch, hv_input_36V_terminal_2pos_5p08_protected.kicad_sch, mcu.kicad_sch, mouse-joystick-pcb.kicad_pcb, mouse-joystick-pcb.kicad_sch, rp2040.kicad_sch, rp2040_gpio_isolation_sn74cb3q3245.kicad_sch, usb2.kicad_sch]
2026-08-16 Progress on schematic
    [5v_to_3v3_tps73733.kicad_sch, hv_to_5v_tpsm365r6.kicad_sch, limit_switch_debounced_input.kicad_sch, mcu.kicad_sch, motor_encoder_limit.kicad_sch, mouse-joystick-pcb.kicad_sch, pycontrol_behavior_port_rj45_boundary.kicad_sch, tmc5130.kicad_sch]
2026-08-17 Progress towards finished schematic
    [instrument_port.kicad_sch, instrument_port_40_dut_ffc_boundary.kicad_sch, instrumentation_signal_buffer_sn74lvc125a_1.kicad_sch, instrumentation_signal_buffer_sn74lvc125a_2.kicad_sch, instrumentation_signal_buffer_sn74lvc125a_3.kicad_sch, mcu.kicad_sch, motor_encoder_limit.kicad_sch, mouse-joystick-pcb.kicad_sch]
2026-08-17 Initial schematic layout complete
    [5v_to_3v3_tps73733.kicad_sch, hv_input_36V_terminal_2pos_5p08_protected.kicad_sch, hv_to_5v_tpsm365r6.kicad_sch, instrument_port_40_dut_ffc_boundary.kicad_sch, instrumentation_signal_buffer_sn74lvc125a_1.kicad_sch, instrumentation_signal_buffer_sn74lvc125a_2.kicad_sch, instrumentation_signal_buffer_sn74lvc125a_3.kicad_sch, limit_switch_debounced_input.kicad_sch]
2026-08-17 Save board analysis for further work
    [mcu.kicad_sch, rp2040_gpio_isolation_sn74cb3q3245.kicad_sch]
2026-08-18 Finish schematic, verified it, updated docs
    [hv_input_36V_terminal_2pos_5p08_protected.kicad_sch, instrument_port.kicad_sch, mcu.kicad_sch, motor_encoder_limit.kicad_sch, mouse-joystick-pcb.kicad_sch, rp2040_gpio_isolation_sn74cb3q3245.kicad_sch]
2026-08-18 Rough design block pcb layout
    [5v_to_3v3_tps73733_1.kicad_sch, 5v_to_3v3_tps73733_2.kicad_sch, hv_input_36V_terminal_2pos_5p08_protected.kicad_sch, hv_to_5v_tpsm365r6.kicad_sch, instrument_port.kicad_sch, instrument_port_40_dut_ffc_boundary.kicad_sch, instrumentation_signal_buffer_sn74lvc125a_1.kicad_sch, instrumentation_signal_buffer_sn74lvc125a_2.kicad_sch]
2026-08-18 Add more routing
    [mouse-joystick-pcb.kicad_pcb]
2026-08-18 More routing
    [instrument_port.kicad_sch, mouse-joystick-pcb.kicad_pcb]
2026-08-18 Finish routing but has errors
    [mouse-joystick-pcb.kicad_pcb]
2026-08-19 Fix DRC errors
    [5v_to_3v3_tps73733_1.kicad_sch, 5v_to_3v3_tps73733_2.kicad_sch, hv_input_36V_terminal_2pos_5p08_protected.kicad_sch, hv_to_5v_tpsm365r6.kicad_sch, instrument_port.kicad_sch, instrument_port_40_dut_ffc_boundary.kicad_sch, instrumentation_signal_buffer_sn74lvc125a_1.kicad_sch, instrumentation_signal_buffer_sn74lvc125a_2.kicad_sch]
2026-08-19 Finished v0.1
    [jlcpcb-bom.csv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]
2026-08-21 Update pycontrol design block and board to v0.2
    [5v_to_3v3_tps73733_1.kicad_sch, 5v_to_3v3_tps73733_2.kicad_sch, hv_input_36V_terminal_2pos_5p08_protected.kicad_sch, hv_to_5v_tpsm365r6.kicad_sch, instrument_port.kicad_sch, instrument_port_40_dut_ffc_boundary.kicad_sch, instrumentation_signal_buffer_sn74lvc125a_1.kicad_sch, instrumentation_signal_buffer_sn74lvc125a_2.kicad_sch]
2026-08-21 Add fab files
    [jlcpcb-bom.csv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]
2026-08-25 Remove some horizontal connectors and replace with vertical
    [5v_to_3v3_tps73733_1.kicad_sch, 5v_to_3v3_tps73733_2.kicad_sch, hv_input_36V_terminal_2pos_5p08_protected.kicad_sch, hv_to_5v_tpsm365r6.kicad_sch, instrument_port.kicad_sch, instrument_port_40_dut_ffc_boundary.kicad_sch, instrumentation_signal_buffer_sn74lvc125a_1.kicad_sch, instrumentation_signal_buffer_sn74lvc125a_2.kicad_sch]
2026-08-25 Place pycontrol vertical block
    [motor_encoder_limit.kicad_sch, mouse-joystick-pcb.kicad_pcb, mouse-joystick-pcb.kicad_sch, pycontrol_behavior_port_rj45_boundary_vertical.kicad_sch, usb2_vertical.kicad_sch]
2026-08-25 Add limit switch vertical design block
    [limit_switch_debounced_input_vertical.kicad_sch, motor_encoder_limit.kicad_sch, mouse-joystick-pcb.kicad_pcb, pycontrol_behavior_port_rj45_boundary_vertical.kicad_sch]
2026-08-25 Add vertical hv_input design block
    [hv_input_36V_terminal_2pos_5p08_protected_vertical.kicad_sch, mouse-joystick-pcb.kicad_pcb, mouse-joystick-pcb.kicad_sch]
2026-08-26 motor_encoder_limit -> motor_encoder_switch
    [motor_encoder_switch.kicad_sch, mouse-joystick-pcb.kicad_pcb, mouse-joystick-pcb.kicad_sch]
2026-08-26 Add DAC design block for angle output
    [analog_output_0_3v3_dac80501.kicad_sch, hv_input_36V_terminal_2pos_5p08_protected_vertical.kicad_sch, limit_switch_debounced_input_vertical.kicad_sch, mcu.kicad_sch, motor_encoder_switch.kicad_sch, mouse-joystick-pcb.kicad_sch]
2026-08-27 Remove analog output block for modifications
    [analog_output_0_3v3_dac80501.kicad_sch, motor_encoder_switch.kicad_sch]
2026-08-27 Update analog output block
    [analog_output_0_3v3_dac80501.kicad_sch, motor_encoder_switch.kicad_sch]
2026-08-27 Verified schematic and updated docs
    [analog_output_0_3v3_dac80501.kicad_sch, instrument_port.kicad_sch, instrumentation_signal_buffer_sn74lvc125a_2.kicad_sch, instrumentation_signal_buffer_sn74lvc125a_3.kicad_sch, instrumentation_signal_buffer_sn74lvc125a_4.kicad_sch, motor_encoder_switch.kicad_sch, mouse-joystick-pcb.kicad_sch]
2026-08-27 Updated pcb from schematic
    [analog_output_0_3v3_dac80501.kicad_sch, instrument_port.kicad_sch, mouse-joystick-pcb.kicad_pcb]
2026-08-28 Finished board routing
    [instrument_port.kicad_sch, mouse-joystick-pcb.kicad_pcb, mouse-joystick-pcb.kicad_sch, pycontrol_behavior_port_rj45_boundary_vertical.kicad_sch, usb2_vertical.kicad_sch]
2026-08-28 Generated v0.3 fab files
    [jlcpcb-bom.csv, limit_switch_debounced_input.kicad_sch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]
2026-08-28 Fix footprint
    [mouse-joystick-pcb.kicad_pcb]
2026-08-31 Update local kicad package to 10.0.6
2026-08-31 Update brake design
2026-08-31 Update docs with new brake control info
2026-09-08 Update date and version
    [5v_to_3v3_tps73733_1.kicad_sch, 5v_to_3v3_tps73733_2.kicad_sch, analog_output_0_3v3_dac80501.kicad_sch, hv_input_36V_terminal_2pos_5p08_protected_vertical.kicad_sch, hv_to_5v_tpsm365r6.kicad_sch, instrument_port.kicad_sch, instrument_port_40_dut_ffc_boundary.kicad_sch, instrumentation_signal_buffer_sn74lvc125a_1.kicad_sch]
2026-09-08 Remove some design blocks for modifications
    [hv_input_36V_terminal_2pos_5p08_protected_vertical.kicad_sch, mcu.kicad_sch, motor_encoder_switch.kicad_sch, mouse-joystick-pcb.kicad_pcb, mouse-joystick-pcb.kicad_sch, quadrature_encoder_input_5v_sn74lvc2g17.kicad_sch, rp2040.kicad_sch]
2026-09-10 Deleted some traces
    [mouse-joystick-pcb.kicad_pcb]
2026-09-14 Update channels files to use guix officical kicad 10.0.6
2026-09-16 Update docs with mouse-joystick-pcb v1.0 pinout
    [5v_to_3v3_tps73733_1.kicad_sch, 5v_to_3v3_tps73733_2.kicad_sch, analog_output_0_3v3_dac80501.kicad_sch, hv_to_5v_tpsm365r6.kicad_sch, instrument_port.kicad_sch, instrument_port_40_dut_ffc_boundary.kicad_sch, instrumentation_signal_buffer_sn74lvc125a_1.kicad_sch, instrumentation_signal_buffer_sn74lvc125a_2.kicad_sch]
2026-09-16 Progress towards v1.0
    [hv_input_36V_terminal_2pos_5p08_protected_vertical.kicad_sch, mcu.kicad_sch, mouse-joystick-pcb.kicad_sch, rp2040_with_gpio_isolation_sn74cb3q3245.kicad_sch]
2026-09-17 Update design rules
    [5v_to_3v3_tps73733_1.kicad_sch, 5v_to_3v3_tps73733_2.kicad_sch, analog_output_0_3v3_dac80501.kicad_sch, hv_input_36V_terminal_2pos_5p08_protected_vertical.kicad_sch, hv_to_5v_tpsm365r6.kicad_sch, instrument_port.kicad_sch, instrument_port_digital_50_dut_ffc_boundary_vertical.kicad_sch, limit_switch_debounced_input_vertical.kicad_sch]
2026-09-18 Finish v1.0 schematic
    [analog_output_0_3v3_dac80501.kicad_sch, brake_current_sink_0_49ma_dac80501.kicad_sch, brake_torque_sensor.kicad_sch, hv_input_36V_terminal_2pos_5p08_protected_vertical.kicad_sch, hv_to_12v_tpsm365r6.kicad_sch, hv_to_5v_tpsm365r6.kicad_sch, instrument_port.kicad_sch, limit_switch_debounced_input_vertical.kicad_sch]
2026-09-18 Initial layout
    [mouse-joystick-pcb.kicad_pcb]
2026-09-18 Initial v1.0 layout
    [mouse-joystick-pcb.kicad_pcb]
2026-09-18 Update some routing before auto router
    [mouse-joystick-pcb.kicad_pcb]
2026-09-19 Update documentation and remove tracks and vias
    [mouse-joystick-pcb.kicad_pcb]
2026-09-19 Partial update of hv input block
    [hv_input_36V_terminal_2pos_5p08_protected_vertical.kicad_sch, instrument_port.kicad_sch, motor_encoder_switch.kicad_sch, mouse-joystick-pcb.kicad_pcb, mouse-joystick-pcb.kicad_sch, tmc5130.kicad_sch]
2026-09-19 Finish placing hv input block
    [hv_input_36V_terminal_2pos_5p08_protected_vertical.kicad_sch, mouse-joystick-pcb.kicad_pcb, mouse-joystick-pcb.kicad_sch]
2026-09-19 Update pycontrol block
    [mouse-joystick-pcb.kicad_pcb, mouse-joystick-pcb.kicad_sch, pycontrol_behavior_port_rj45_boundary_vertical.kicad_sch]
2026-09-19 Add inst resistor to rp2040 block
    [mcu.kicad_sch, mouse-joystick-pcb.kicad_pcb, mouse-joystick-pcb.kicad_sch, rp2040_with_gpio_isolation_sn74cb3q3245.kicad_sch]
2026-09-20 Update rp2040 block
    [mcu.kicad_sch, mouse-joystick-pcb.kicad_pcb, mouse-joystick-pcb.kicad_sch]
2026-09-20 Update brake design block and remove torque block
    [brake_current_sink_0_49ma_dac80501.kicad_sch, brake_torque_sensor.kicad_sch, mouse-joystick-pcb.kicad_pcb, mouse-joystick-pcb.kicad_sch, torque_bridge_0_3v3_ina821.kicad_sch]
2026-09-20 Update limit switch block
    [instrument_port.kicad_sch, limit_switch_debounced_input_vertical.kicad_sch, motor_encoder_switch.kicad_sch, mouse-joystick-pcb.kicad_pcb, mouse-joystick-pcb.kicad_sch]
2026-09-20 Update quadrature design block
    [instrument_port.kicad_sch, motor_encoder_switch.kicad_sch, mouse-joystick-pcb.kicad_pcb, mouse-joystick-pcb.kicad_sch, quadrature_encoder_input_5v_sn74lvc2g17.kicad_sch]
2026-09-20 Finish v1.0 block replacement for inst resistors
    [brake_torque_sensor.kicad_sch, mouse-joystick-pcb.kicad_pcb, mouse-joystick-pcb.kicad_sch, torque_bridge_0_3v3_ina821.kicad_sch]
2026-09-20 Update dru
    [mouse-joystick-pcb.kicad_pcb]
2026-09-20 Fix errors before more routing
    [mouse-joystick-pcb.kicad_pcb]
2026-09-20 Route 36V and motor signals and add GND zone and track keep out
    [mouse-joystick-pcb.kicad_pcb]
2026-09-20 Remove GND zone and keepout zone
    [mouse-joystick-pcb.kicad_pcb]
2026-09-20 Edit → Cleanup Tracks & Vias (merge collinear, delete redundant, delete tracks in pads, delete dangling)
    [mouse-joystick-pcb.kicad_pcb]
2026-09-20 Lock all tracks and vias
    [mouse-joystick-pcb.kicad_pcb]
2026-09-20 Add D+/D- traces
    [mouse-joystick-pcb.kicad_pcb]
2026-09-21 After experiments with autorouter
    [mouse-joystick-pcb.kicad_pcb]
2026-09-21 Six layer board
    [mouse-joystick-pcb.kicad_pcb]
2026-09-21 Routing success
    [jlcpcb-bom.csv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]
2026-09-21 Move connectors to make room for cables
    [connector-positions.csv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]
2026-09-21 Add documentation and correct component rotations for jlcpcb
    [connector-positions.csv, connectors.csv, jlcpcb-bom.csv, mounting-holes.csv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]
2026-09-21 Improve the documentation
    [mouse-joystick-pcb-assembled.step, mouse-joystick-pcb.step]
2026-09-21 Update channels file to use latest mcp-server-kicad
2026-10-01 Update uart-protocol
2026-10-01 Step 3c complete
    [mechanical-datums.csv]
2026-10-05 Update to use latest kicad-libs
2026-10-08 Update kicad local to 10.0.7
2026-10-08 Update board-manifest
2026-10-13 Regenerate schematics
    [5v_to_3v3_tps73733_1.kicad_sch, 5v_to_3v3_tps73733_2.kicad_sch, analog_output_0_3v3_dac80501.kicad_sch, brake_current_sink_0_49ma_dac80501.kicad_sch, brake_torque_sensor.kicad_sch, connectors.csv, hv_input_36V_terminal_2pos_5p08_protected_vertical.kicad_sch, hv_to_12v_tpsm365r6.kicad_sch]
2026-10-14 Add github page
    [mouse-joystick-pcb-assembled.step, mouse-joystick-pcb.kicad_pcb]
2026-10-14 Add more materials to components
    [mouse-joystick-pcb-assembled.step]
2026-10-15 Regenerated files
    [mouse-joystick-pcb-assembled.step]
2026-10-16 Add conversion files
    [station-torque-table.csv]
2026-10-16 Add rig 1 calibration
    [station-torque-table.csv]
